vks007/smart-door-sensor/Schematic/Door Sensor - close up back.jpg

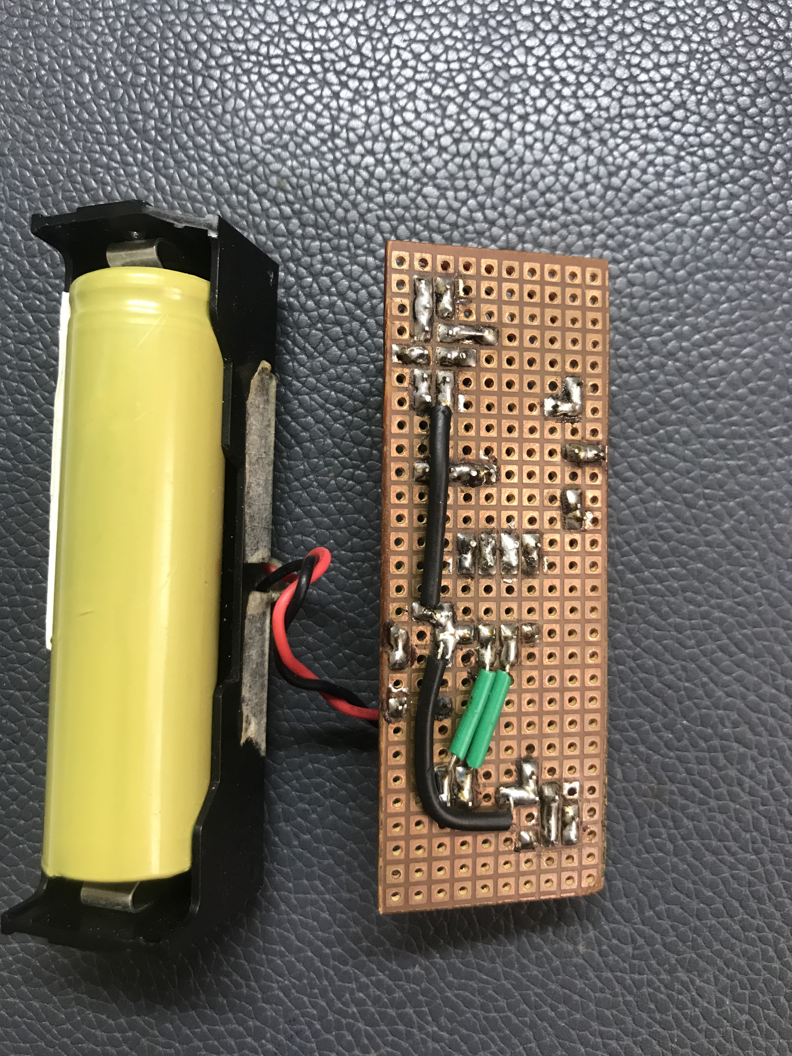
Schematic/Door Sensor - close up back.jpg
