vks007/smart-door-sensor/README.md

# smart-door-sensor
Wireless Door Sensor - Ultra Low Power

Please refer to the instructable here for details: https://www.instructables.com/id/Wireless-Door-Sensor-Ultra-Low-Power/
