vks007/smart-door-sensor/Schematic/Door Sensor - close up top.jpg

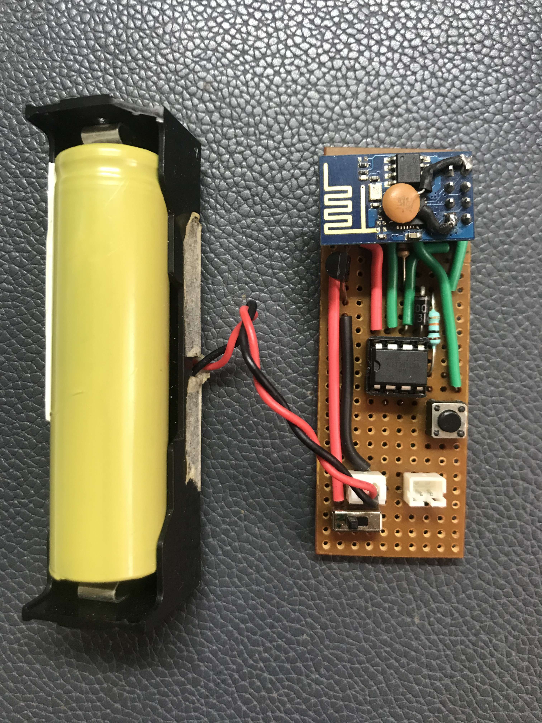
Schematic/Door Sensor - close up top.jpg
