vks007/smart-door-sensor/Schematic/Schematic_Smart-Door-Sensor.png

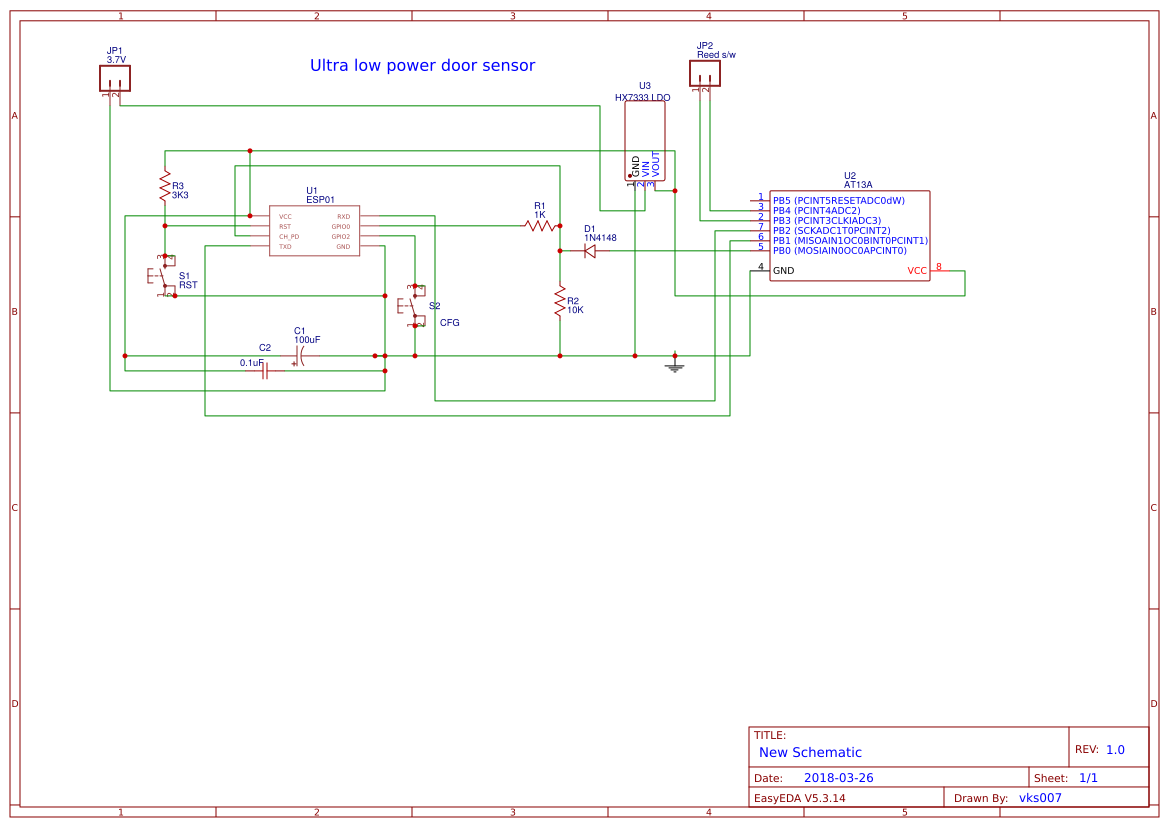
Schematic/Schematic_Smart-Door-Sensor.png
