vks007/smart-door-sensor/Schematic/Door Sensor - Installed on door.jpg

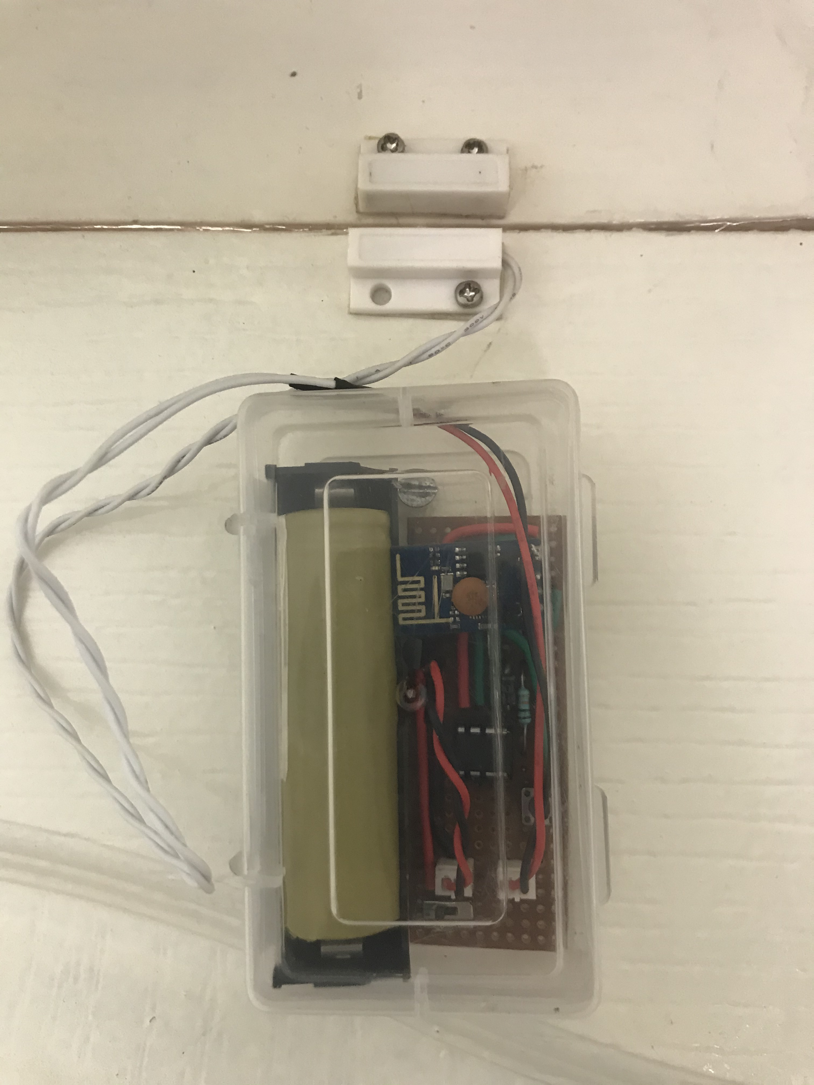
Schematic/Door Sensor - Installed on door.jpg
