vks007/smart-door-sensor/Schematic/Door Sensor - PCB layout.jpg

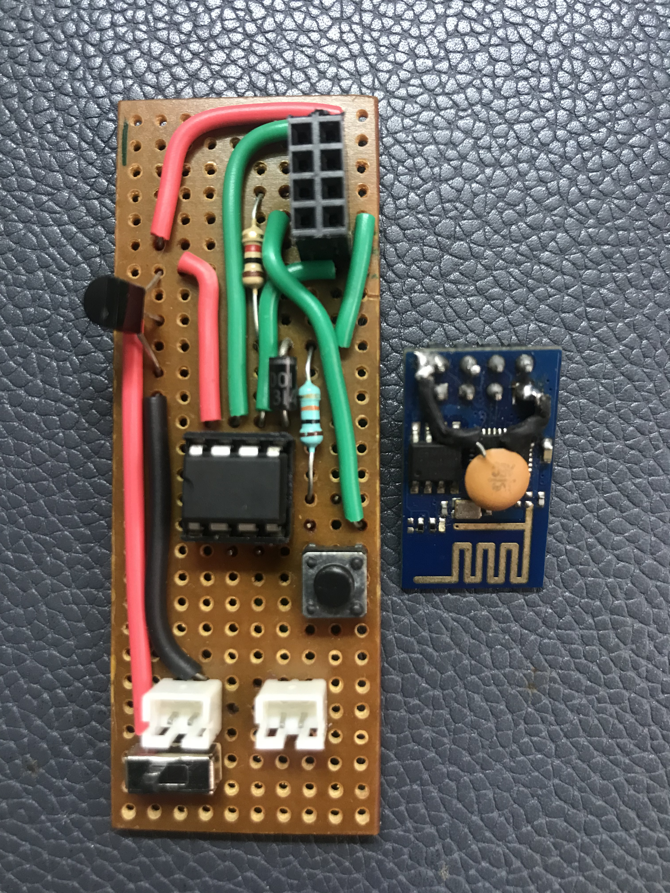
Schematic/Door Sensor - PCB layout.jpg
